iamsidge/thirst-trap/renders/exploded.png

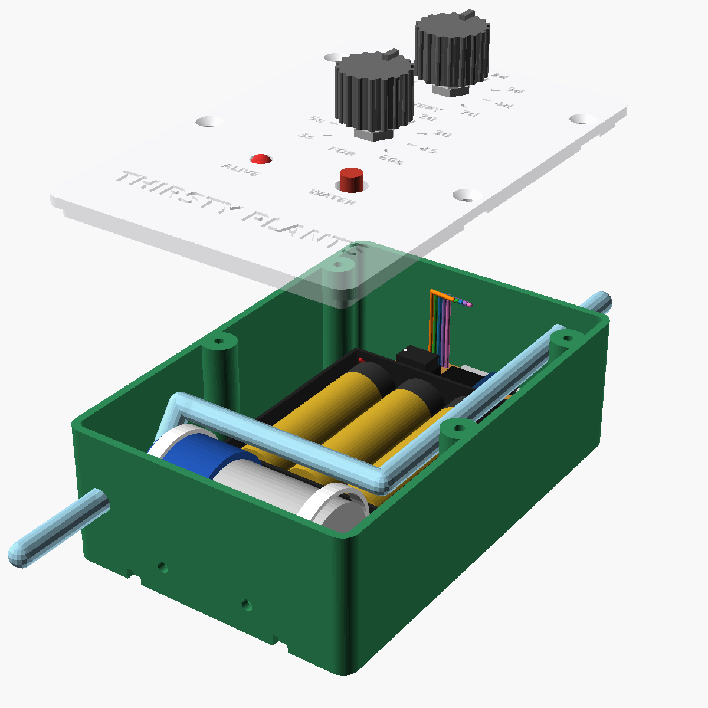
renders/exploded.png
