iamsidge/thirst-trap/renders/inside_top.png

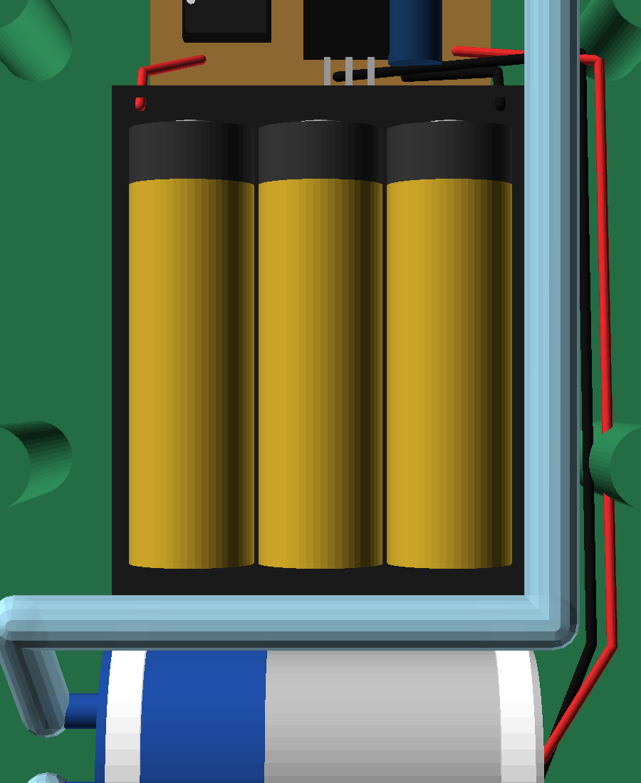
renders/inside_top.png
