iamsidge/thirst-trap/PARTS-AMAZON.md

# Amazon UK parts list

Prices checked 20 Oct 2026. They move, so check before you buy. Amazon sells in packs, so this basket makes 2–5 units.

| Part | Listing | Pack | £ |
|---|---|---|---|
| ATtiny85-20PU | [2× ATMEL ATtiny85](https://www.amazon.co.uk/dp/B00PT4XU04) | 2 | 7.95 |
| USBasp programmer | [DollaTek USBasp](https://www.amazon.co.uk/dp/B07DK4NBL4) | 1 | 4.99 |
| Pump 3–6 V, 0.6 L/min, 80 mA | [3-pack](https://www.amazon.co.uk/dp/B0HBYFNR9K) | 3 | 8.36 |
| Silicone tube 4×6 mm | [QWORK 3 m](https://www.amazon.co.uk/dp/B0FG2Y7GNQ) | 3 m | 4.99 |
| 3×AA holder | [GTIWUNG](https://www.amazon.co.uk/dp/B07WGY91YC) | 6 | 5.99 |
| IRLZ44N MOSFET | [12 pcs](https://www.amazon.co.uk/dp/B0HJZG39DL) | 12 | 5.79 |
| WH148 B10K pot (3-pin) | [BOJACK](https://www.amazon.co.uk/dp/B07ZJL91YP) | 10 | 6.99 |
| 7 mm momentary button | [sourcing map](https://www.amazon.co.uk/dp/B0D8J5R72H) | 10 | 5.19 |
| Resistors / caps / LEDs / diodes | [1390-pc kit](https://www.amazon.co.uk/dp/B087WXL5GT) | kit | 13.99 |
| Stripboard | [5-pack](https://www.amazon.co.uk/dp/B0F5593SNN) | 5 | 5.69 |
| M3 countersunk screws + nuts | [set](https://www.amazon.co.uk/dp/B0DQ17YKWR) | 496 | 5.59 |
| **Total** | | | **75.52** |

The core parts, without the component kit, stripboard and screws, come to £50.25.

- The pump is small, so measure it and set `pump_d` / `pump_body` in `thirsty_plants.scad` before you print the box.
- Check the kit photo for a 220 µF capacitor and a 1N4007 or 1N5819 diode.
- Skip the Digispark boards: their USB parts sit on PB3/PB4, which are the pot inputs.
