iamsidge/thirst-trap/stl/lid.stl

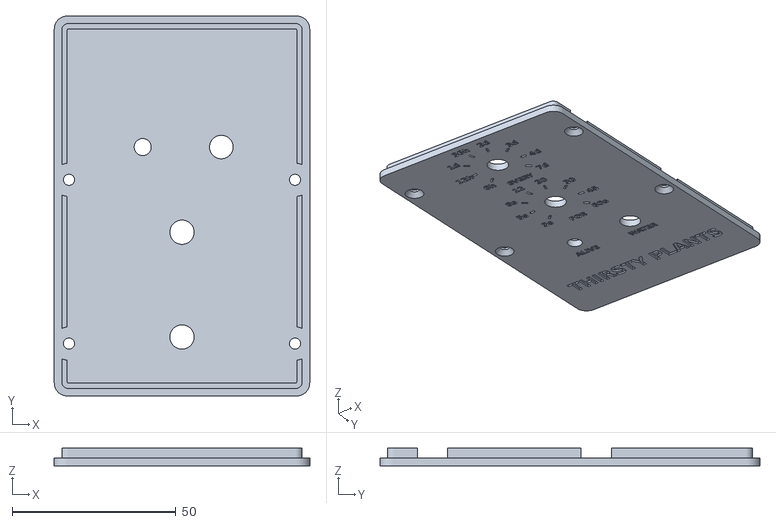
[picture p5: CAD file, 2026-10-21]
stl/lid.stl
78.0 x 116.0 x 5.40
