iamsidge/thirst-trap/stl/box.stl

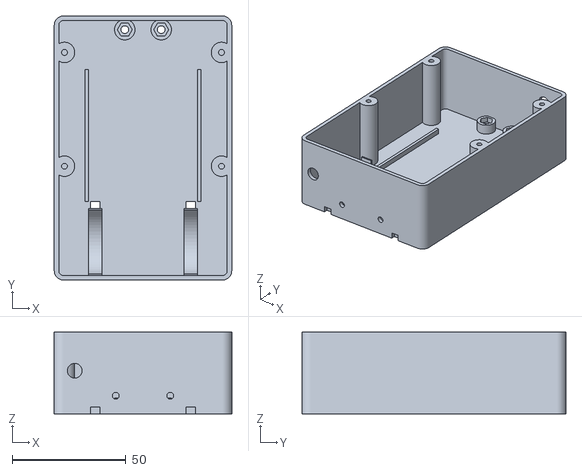
[picture p6: CAD file, 2026-10-20]
stl/box.stl
78.0 x 116.0 x 36.0
