iamsidge/thirst-trap/stl/stake.stl

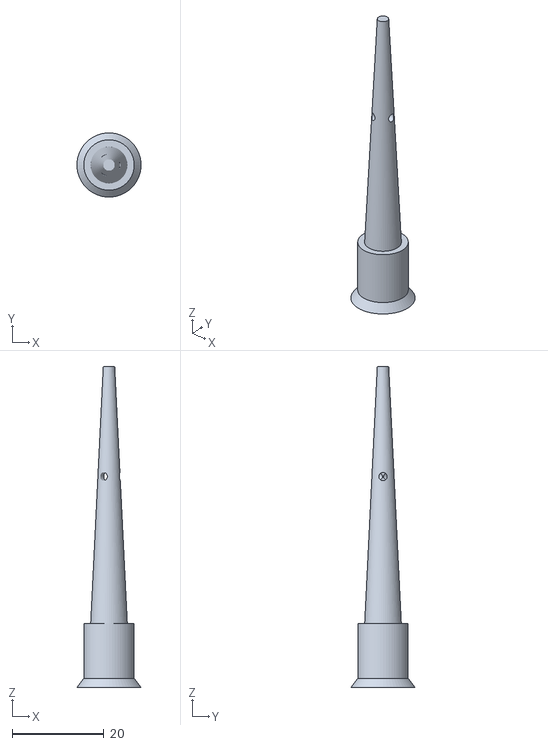
[picture p7: CAD file, 2026-10-20]
stl/stake.stl
14.0 x 14.0 x 70.0
