iamsidge/thirst-trap/stl/knob.stl

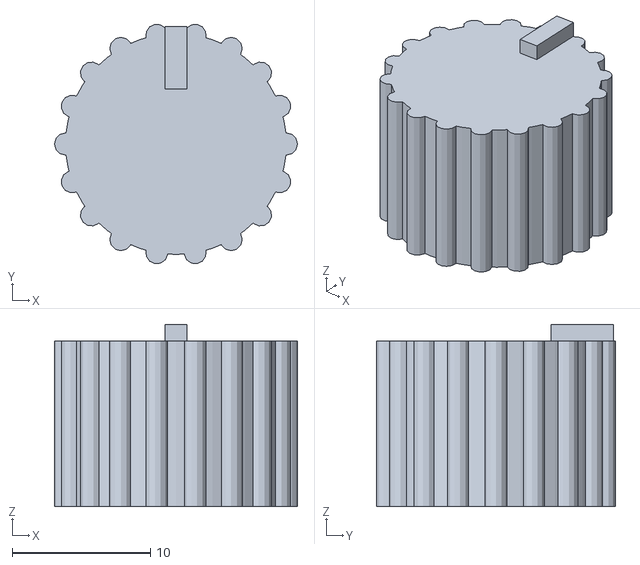
[picture p8: CAD file, 2026-10-20]
stl/knob.stl
17.6 x 17.3 x 13.2
