iamsidge/thirst-trap/stl/sinker.stl

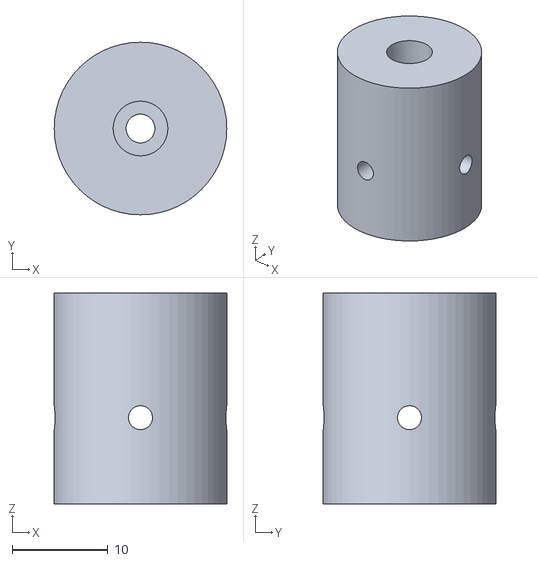
[picture p9: CAD file, 2026-10-20]
stl/sinker.stl
18.0 x 18.0 x 22.0
