iamsidge/thirst-trap/stl/clip.stl

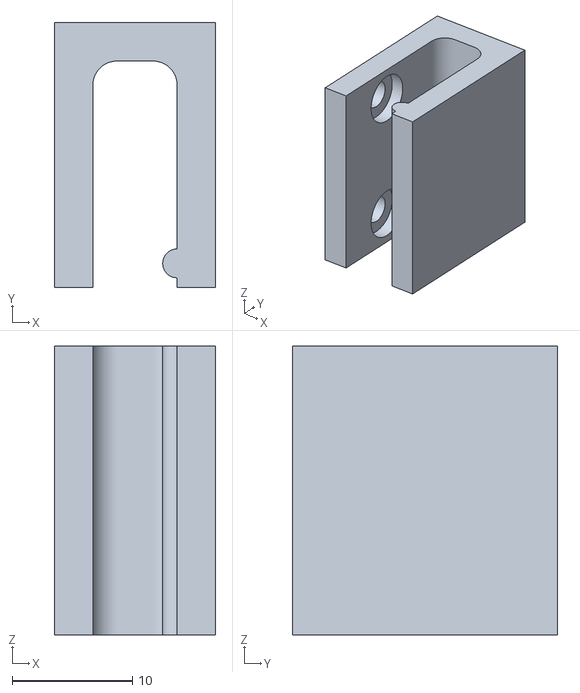
[picture p10: CAD file, 2026-10-20]
stl/clip.stl
13.4 x 22.0 x 24.0
