iamsidge/thirst-trap/(commit log)

2026-10-20 Add README, licence, Amazon parts list and OpenSCAD source
    [thirst_trap.scad]
2026-10-20 Add print-ready STLs
    [box.stl, clip.stl, knob.stl, lid.stl, sinker.stl, stake.stl]
2026-10-21 Add schematic and stripboard layout
2026-10-21 README: embed wiring diagrams
2026-10-21 Rename project to Thirsty Plants
    [thirsty_plants.scad]
2026-10-21 Lid: engrave THIRSTY PLANTS
    [lid.stl]
